Sven-J-Steinert/MomenTUM/README.md

# MomenTUM
Spacecraft Propulsion and Design Challenge, Mission to Phobos
