Sven-J-Steinert/MomenTUM/doc/img/nx_rcs.png

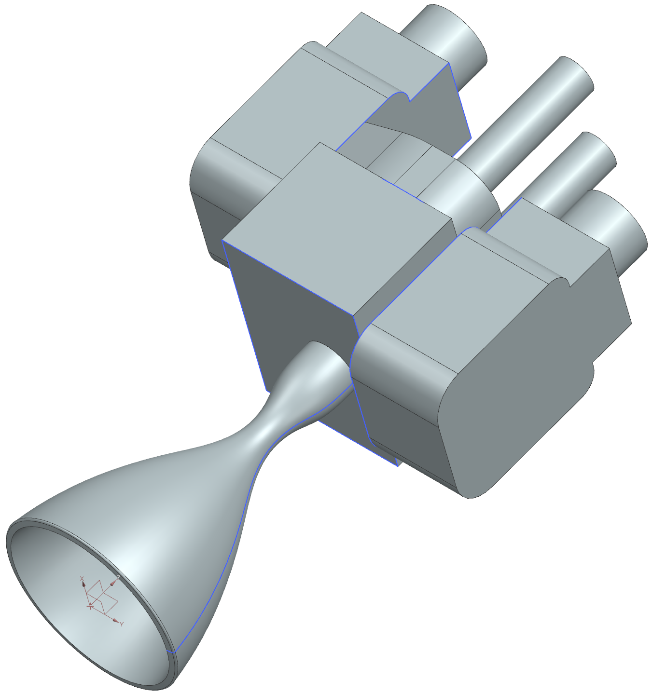
doc/img/nx_rcs.png
