Sven-J-Steinert/MomenTUM/doc/img/orbit.jpg

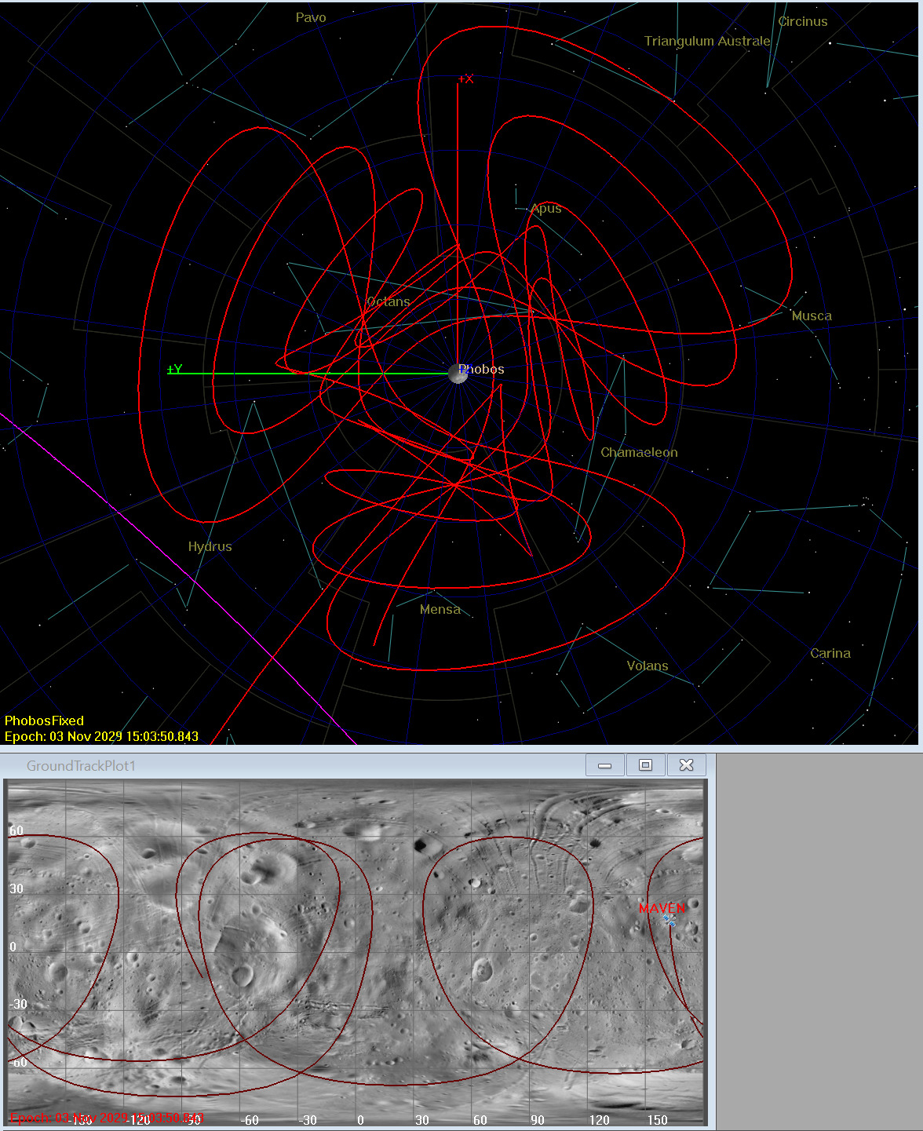
doc/img/orbit.jpg
