Sven-J-Steinert/MomenTUM/NX/PROP.PNG

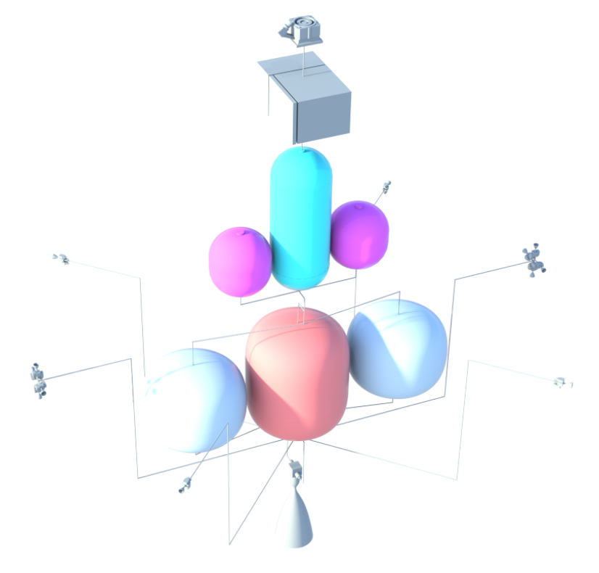
NX/PROP.PNG
