Sven-J-Steinert/MomenTUM/(list of files, cad)

Other CAD files:
NX/Ariane62.prt
NX/Assembly_MomenTUM.prt
NX/BiProp_tank_OST-25-0_198l.prt
NX/BiProp_tank_OST-25-0_282l.prt
NX/BiProp_tank_OST-25-0_331l.prt
NX/Electric_BPRU.prt
NX/Electric_BPRU_new.prt
NX/Electric_PPS-1350-G.prt
NX/Electric_PPS-1350-G_new.prt
NX/Electric_Sys_placeholder.prt
NX/Helium_tank_PVG_Family_50l.prt
NX/INS.prt
NX/Main_S400-15.prt
NX/MomenTUM_2_tanks.prt
NX/MomenTUM_3_tanks.prt
NX/MomenTUM_3_tanks_Xenon.prt
NX/MomenTUM_3_tanks_Xenon_dwg1.prt
NX/MomenTUM_3_tanks_dwg1.prt
NX/MomenTUM_4_tanks.prt
NX/PLA6 1194.prt
NX/RCS_S10-26.prt
NX/Small_Faring.prt
NX/SolarArray_closed.prt
NX/SolarArray_open.prt
NX/Xenon_tank_S-XTA-120l.prt
NX/Xenon_tank_S-XTA-60l.prt
