Sven-J-Steinert/MomenTUM/NX/technical_drawing.pdf

# MomenTUM

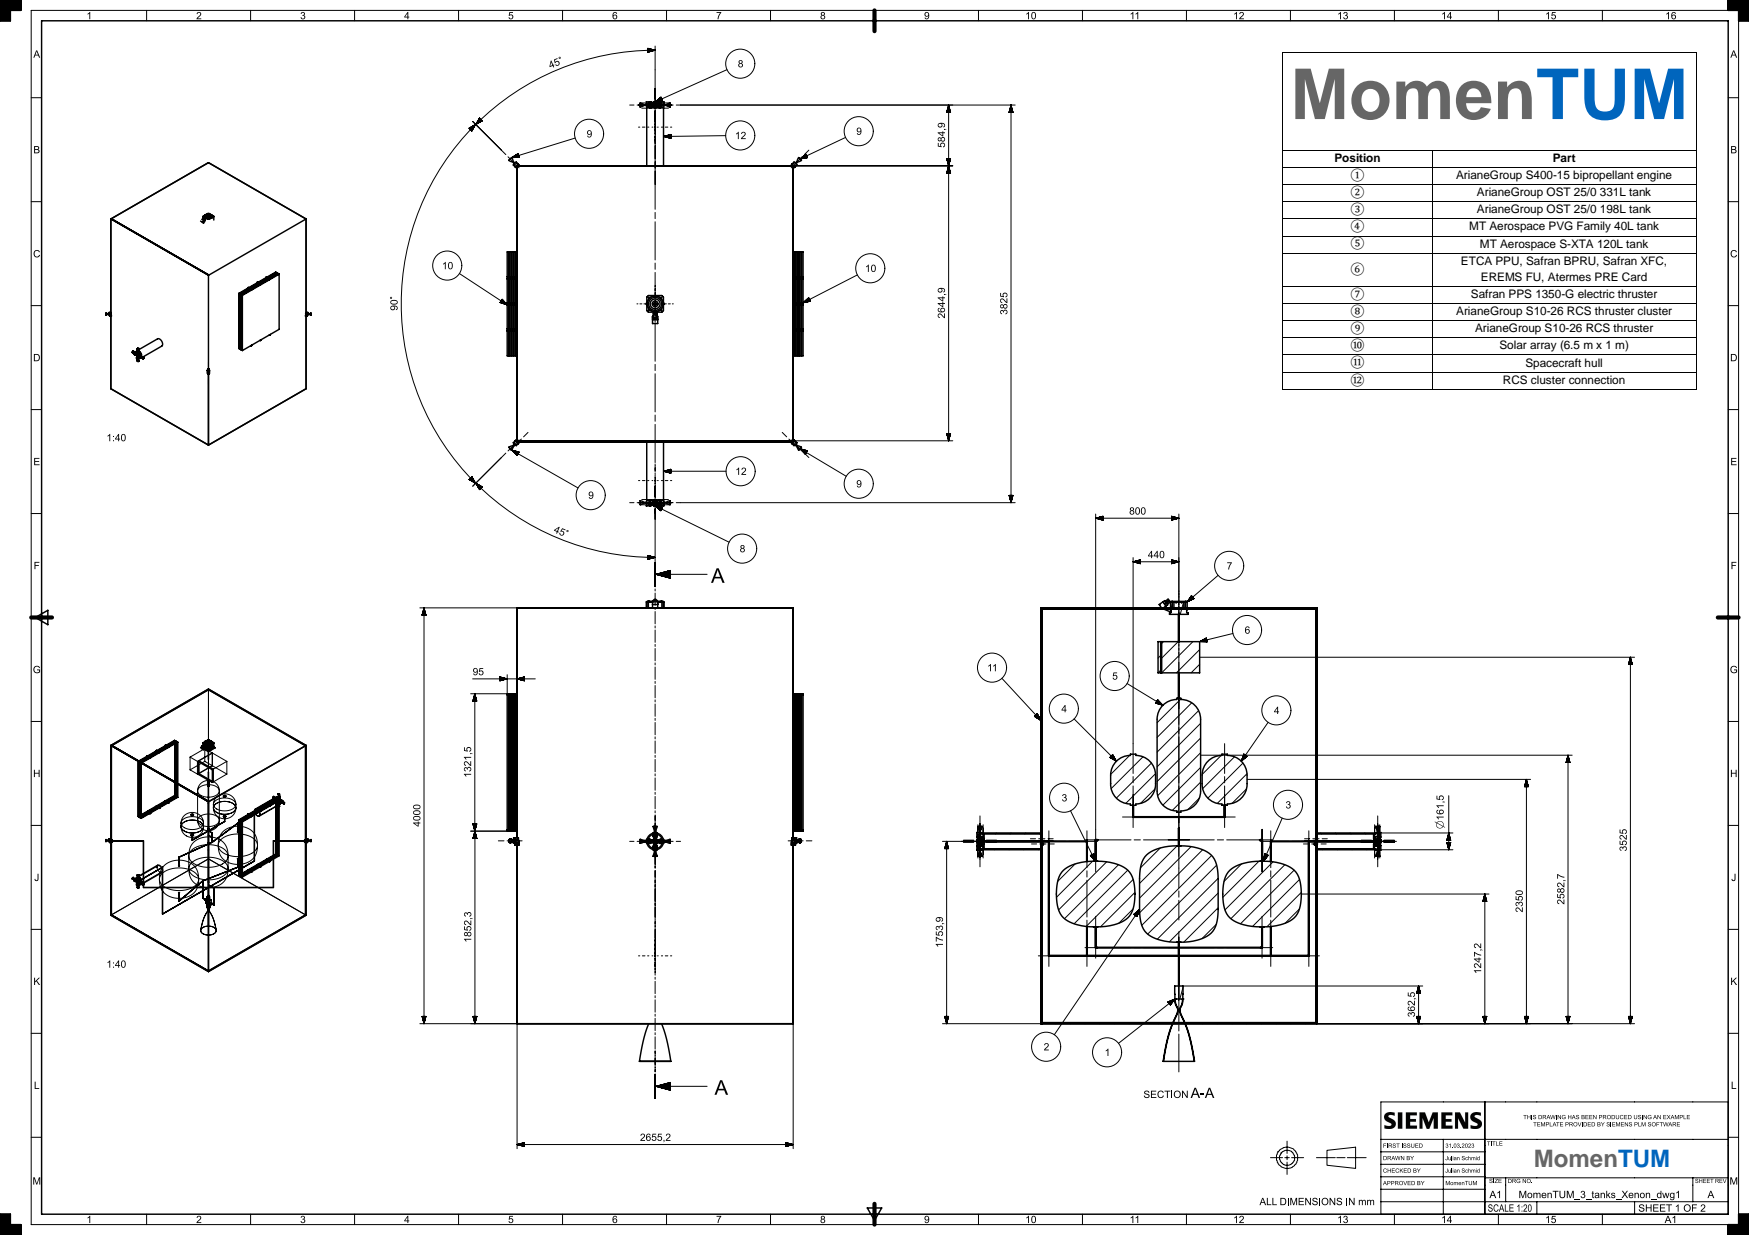
[picture p29: page 1]
MomenTUM

Position | Part
① | ArianeGroup S400-15 bipropellant engine
② | ArianeGroup OST 25/0 331L tank
③ | ArianeGroup OST 25/0 198L tank
④ | MT Aerospace PVG Family 40L tank
⑤ | MT Aerospace S-XTA 120L tank
⑥ | ETCA PPU, Safran BPRU, Safran XFC, EREMS FU, Atermes PRE Card

⑦ | Safran PPS 1350-G electric thruster
⑧ | ArianeGroup S10-26 RCS thruster cluster
⑨ | ArianeGroup S10-26 RCS thruster
⑩ | Solar array (6.5 m x 1 m)
⑪ | Spacecraft hull
⑫ | RCS cluster connection

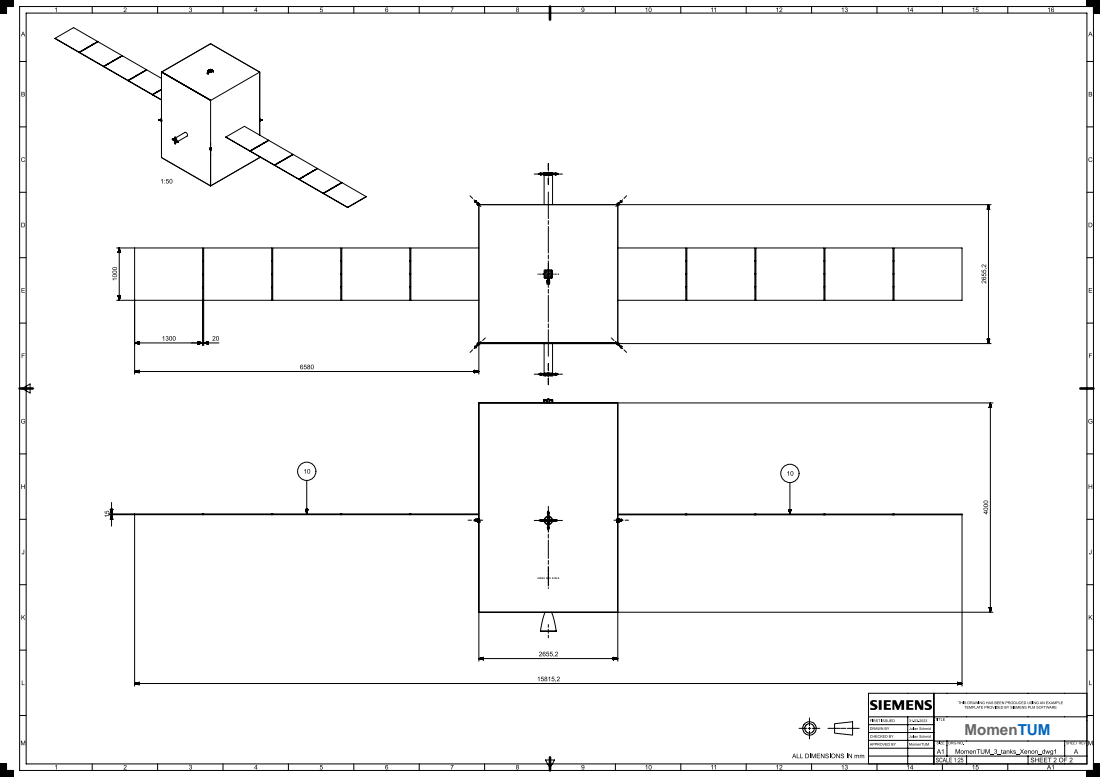
[picture p30: page 2]
MomenTUM
