Sven-J-Steinert/MomenTUM/doc/img/electric_flowchart.pdf

# SMART-1 Adaption

# Electric Propulsion Flowchart

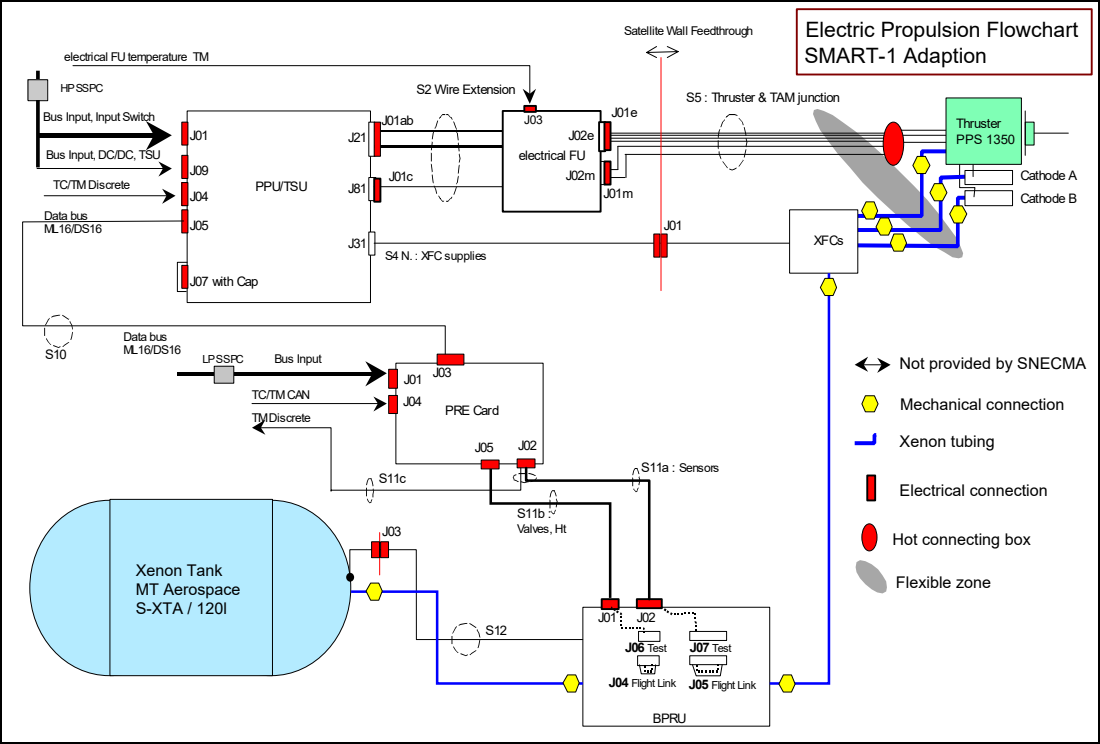
[picture p31: page 1]

electrical FU temperature TM

Bus Input, DC/DC, TSU
TC/TMDiscrete
Data bus

Not provided by SNECMA
Mechanical connection
Xenon tubing

J04 Flight Link J05 Flight Link
