Sven-J-Steinert/MomenTUM/doc/img/work_flow.pdf

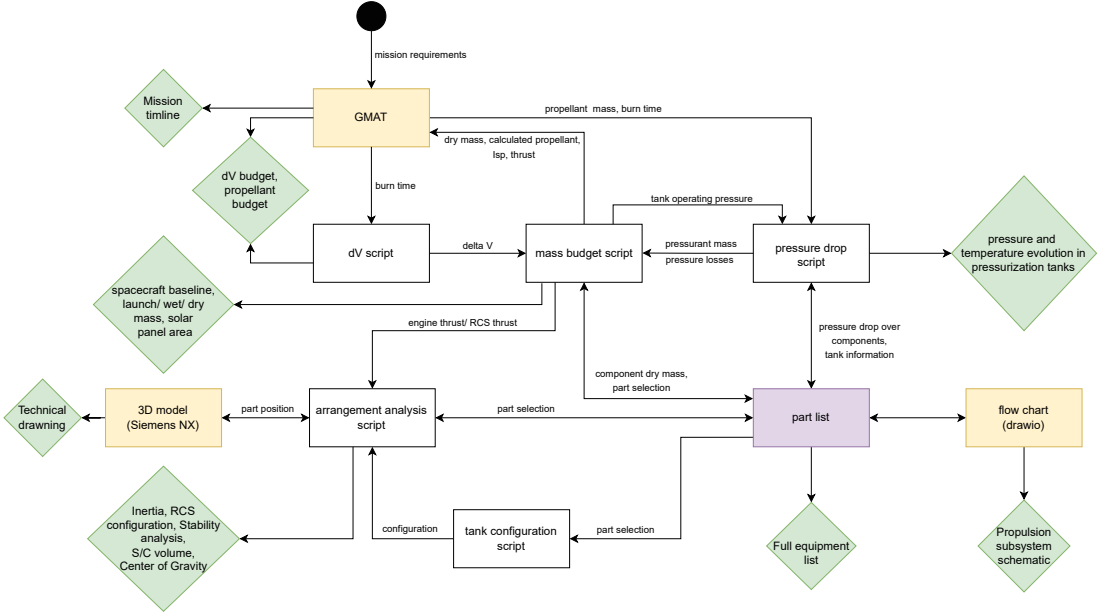
[picture p32: page 1]
GMAT; dV script; burn time; arrangement analysis script; pressure drop script; part list; pressurant mass; 3D model (Siemens NX); flow chart (drawio); tank configuration script; Technical drawning; Isp, thrust; pressure losses; Propulsion subsystem schematic; Full equipment list; dV budget, propellant budget; Mission timline; delta V; configuration; part selection; mission requirements; part position

propellant mass, burn time

dry mass, calculated propellant,

tank operating pressure

pressure and
temperature evolution in
pressurization tanks

mass budget script

spacecraft baseline,
launch/ wet/ dry
mass, solar
panel area

engine thrust/ RCS thrust

pressure drop over
components,
tank information

component dry mass,
part selection

Inertia, RCS
configuration, Stability
analysis,
S/C volume,
Center of Gravity
