Sven-J-Steinert/MomenTUM/doc/pdf/Flowchart_Biprop.pdf

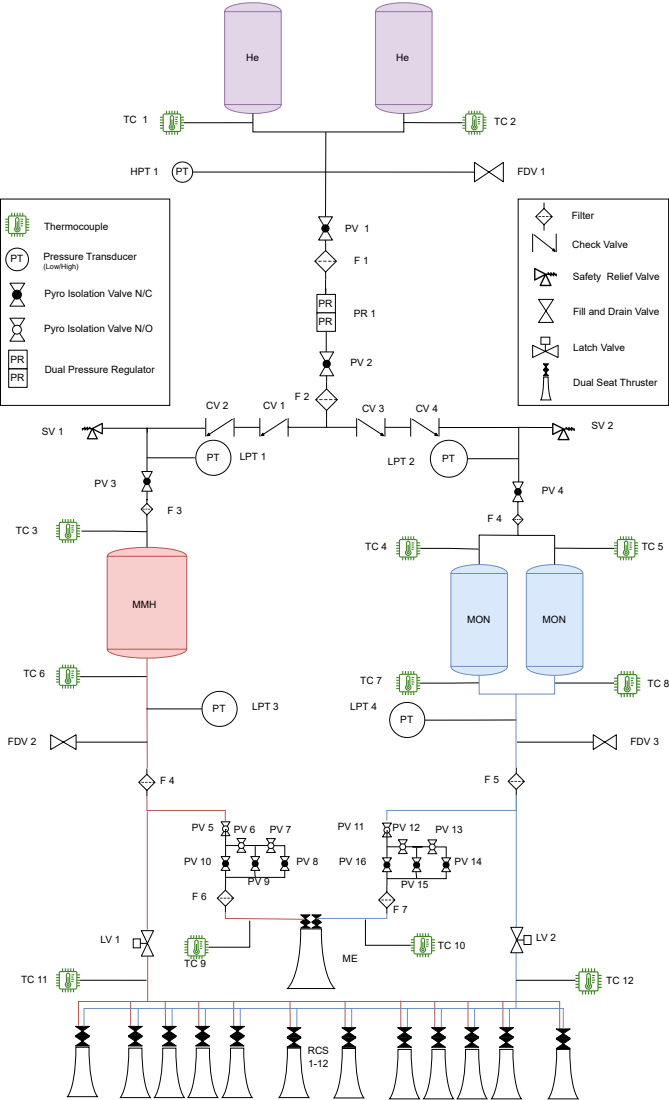
[picture p33: page 1]
MMH; MON; Pressure Transducer; Latch Valve; Filter; Dual Pressure Regulator; Check Valve; Thermocouple; HPT 1; FDV 1; FDV 2; FDV 3; LPT 1; LPT 2; LPT 3; LPT 4; RCS 1-12

(Low/High)
Pyro Isolation Valve N/C

Safety Relief Valve

Fill and Drain Valve

Pyro Isolation Valve N/O

Dual Seat Thruster
