Sven-J-Steinert/MomenTUM/doc/pdf/PaarwiseAnalysis.pdf

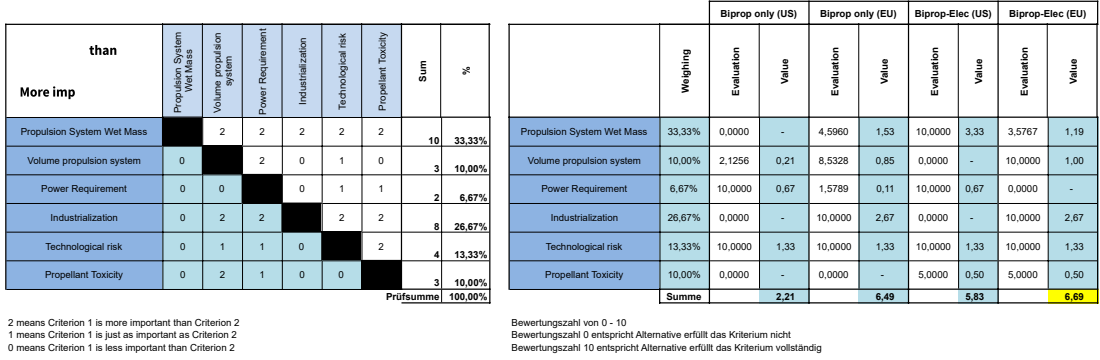
[picture p34: page 1]
Biprop only (US); Biprop only (EU); Biprop-Elec (US); Biprop-Elec (EU); Propulsion System Wet Mass; Volume propulsion; system; Power Requirement; Industrialization; Technological risk; Propellant Toxicity; Sum; Weighing; Evaluation; Value; Volume propulsion system; Prüfsumme; Summe; 2 means Criterion 1 is more important than Criterion 2; Bewertungszahl von 0 - 10; 1 means Criterion 1 is just as important as Criterion 2; Bewertungszahl 0 entspricht Alternative erfüllt das Kriterium nicht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
