Sven-J-Steinert/MomenTUM/(commit log)

2023-03-28 GMAT import
    [RMAG_phobos.csv]
2023-03-31 xlsx include
    [GMAT_values_20.xlsx]
2023-03-31 NX import
    [Ariane62.prt, Assembly_MomenTUM.prt, BiProp_tank_OST-25-0_198l.prt, BiProp_tank_OST-25-0_282l.prt, BiProp_tank_OST-25-0_331l.prt, Electric_BPRU.prt, Electric_BPRU_new.prt, Electric_PPS-1350-G.prt]
